elhep/FMC_ADC_4CHA_1G_12B/DOC/bot.png

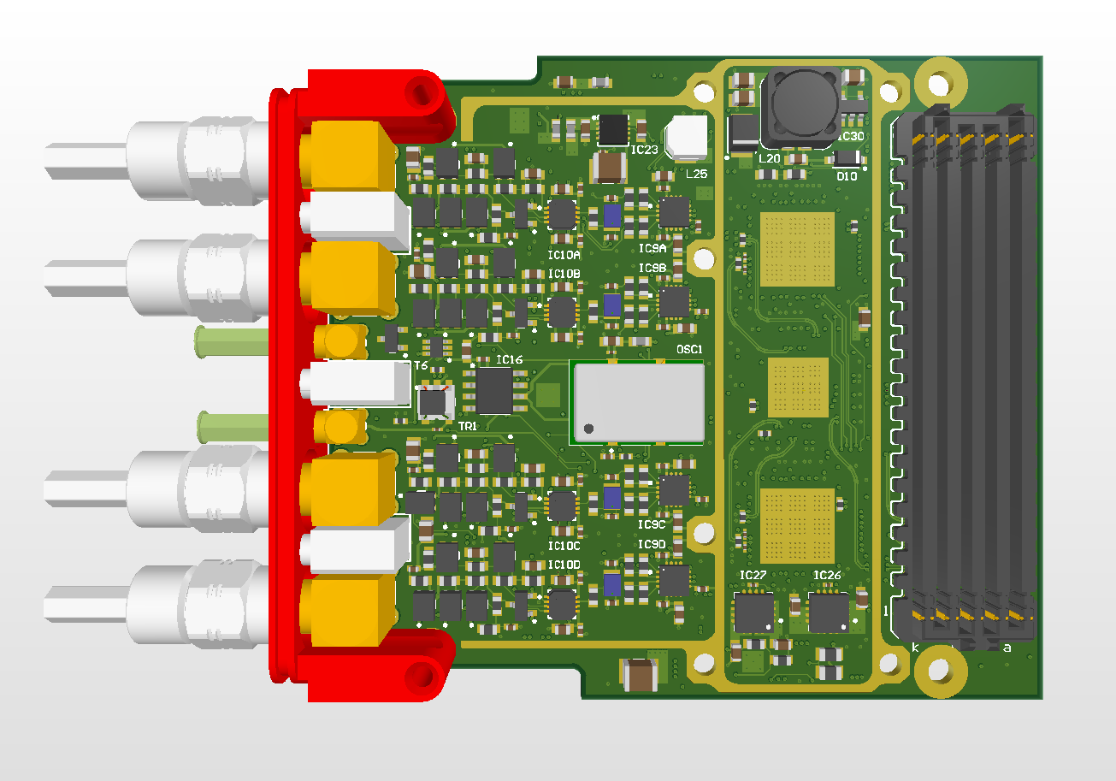
DOC/bot.png
