elhep/FMC_ADC_4CHA_1G_12B/DOC/top.png

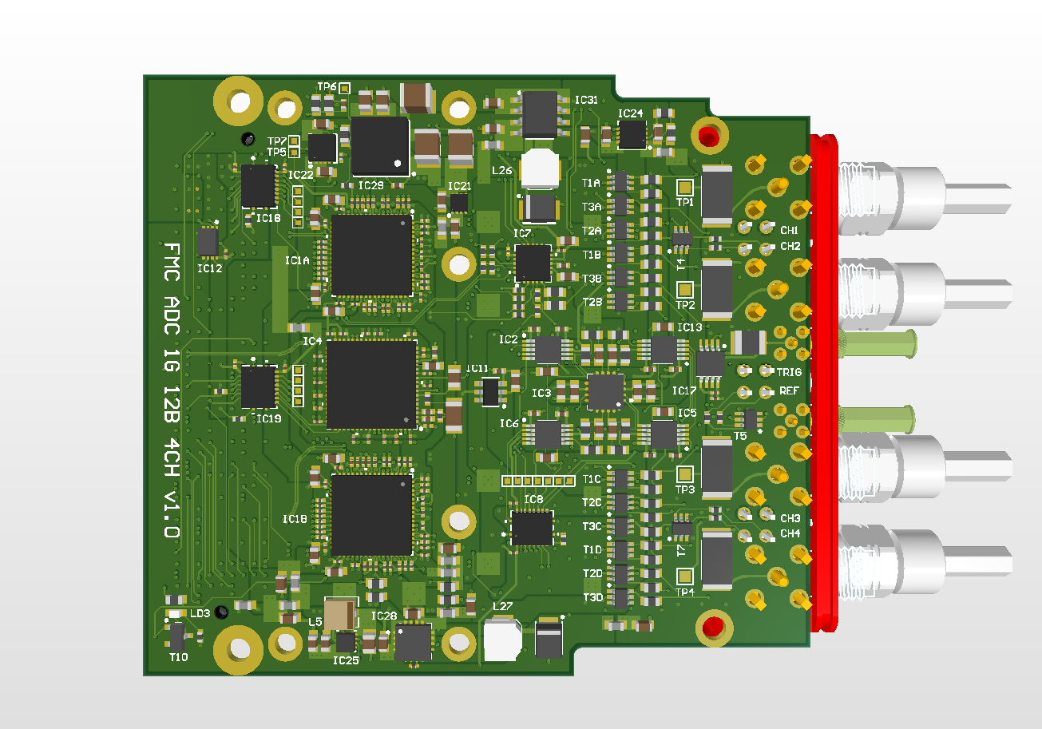
DOC/top.png
