elhep/FMC_ADC_4CHA_1G_12B/Simulation/AFE/input_stage_0_5V.asc

C1: cap; 1.5p
C2: cap; 10p
C3: cap; 33p
C4: cap; 3.3p
C5: cap; 3.3p
C6: cap; 10p
C9: cap; 0.2p
C10: cap; 0.2p
C12: cap; 1.5p
C13: cap; 1.5p
C14: cap; 1.5p
C15: cap; 15p
L1: ind; 150n
R1: res; 86.6
R2: res; 825
R3: res; 187
R4: res; 68.1
R7: res; 825
R8: res; 86.6
R9: res; 3010
R10: res; 825
R11: res; 86.6
R12: res; 86.6
R13: res; 825
R18: res; 5.5
R19: res; 52.3
R20: res; 255
R21: res; 340
R22: res; 340
R23: res; 50
R24: res; 50
T1: tline
U1: ADA4817
U3: ADA4927
V1: voltage; 5
V2: voltage; -5
V3: voltage; SINE(1 0.5 10k); AC 1
V4: voltage; 2.05
V7: voltage; 1
Named nets: 0, VCC, VEE, IN, OCM, OFFS, OUT_P, OUT_N
;.tran 1u
.ac dec 100 10Meg 2G
;.tran 0.4m
