elhep/FMC_ADC_4CHA_1G_12B/(list of files, drawings)

Other design files:
FMC_ADC.PrjPcb
Schematics/ADC.SchDoc
Schematics/ANALOG_INPUT.SchDoc
Schematics/ANALOG_INPUT_CTRL.SchDoc
Schematics/CLOCK.SchDoc
Schematics/CON_FMC_400PIN.SchDoc
Schematics/FMC_ADC_top.SchDoc
Schematics/FMC_CONNECTOR.schdoc
Schematics/LEVEL_TRANSLATORS.SchDoc
Schematics/POWER_SUPPLY_1.SchDoc
Schematics/POWER_SUPPLY_2.SchDoc
Schematics/TRIGGER.SchDoc
Schematics/VOLTAGE_MONITOR.SchDoc
