elhep/FMC_ADC_4CHA_1G_12B/(threads)

Thread 2 (2019-11-04):

Tests [version 1.0]

atcher0, 2019-11-04:
## Tests

####   Power Supply
* [x] Power Supply
**Tested**: voltage level + PG + LEDs

#### IC
**NOTE**: I2C CLK: 100 kHz; SPI CLK: 5 MHz
- [x] EEPROM (24AA64T)
  **TESTED**: read, write
- [x] AD7291 (ADC - voltage monitor)
  **TESTED**: temperature and voltage measurements
- [ ] AD9234 (ADC)
  **TESTED**: SPI communication
- [ ] AD9528 (CLK)
  **TESTED**: SPI communication
- [x] MAX5442 (offset correction DAC)
  **NOTE:** measured range: <- 4.83 V;  4.86 V>

#### ADC analog input
- [ ] Offset correction ( +/-5 V)
- [ ] Gain steps (+/-50 mV, +/-0.5 V, +/-5 V)
- [ ] Bandwidth
- [ ] Linearity
- [ ] FFT analysis

#### Others
- [ ] Trigger
- [x] LEDs

atcher0, 2020-01-13:
f_in = 10 MHz

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

atcher0, 2020-01-13:
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

gkasprow, 2020-01-13:
What generator did you use? Is it DDS? It may have a lot of harmonics.

atcher0, 2020-01-13:
Keysight 33621A

gkasprow, 2020-01-13:
Yes. I have a much better one at the WUT, SMB100A which has much lower phase noise and harmonics. It's also good to connect LPF before to reduce them. Bring the stuff to WUT for characterisation

atcher0, 2020-01-14:
Yes, SMB100A is much better. I will come on Thursday.

atcher0, 2020-01-25:
I repeated my measurements using SMB100A generator and LP (SLP-15+; DC to 15 MHz) filter.
Here are the results:
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

atcher0, 2020-01-25:
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

gkasprow, 2020-01-25:
It looks much better now :)

gkasprow, 2020-01-25:
Add testing of the external clock input

gkasprow, 2020-01-25:
You can use the second SMB100A generator.
Also, test the trigger IO.

Thread 3 (2020-02-02):

panel fixing hole

gkasprow, 2020-02-02:
one of panel fixing holes is shifted
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

gkasprow, 2020-02-02:
Please add stp panel to the design.
[Panel1.zip](https://github.com/elhep/FMC_ADC_4CHA_1G_12B/files/4145314/Panel1.zip)
